Verbeast2K/zanzi-doc/README.md

# Index

## Gateway

- [BOM](./gateway/BOM.md)
- [Installation](./gateway/Installation.md)

## Backend

- [Infrastructure](./backend/infrastructure.md)
- [Installation via Ansible](./backend/ansible.md)
- [Influxdb](./backend/influxdb.md)

## Frontend

- [Grafana](./frontend/grafana.md)
