Verbeast2K/zanzi-doc/sensorbox/powersupply/README.md

# This map contains the files about the power supply and power usage of the sensor box
