Verbeast2K/zanzi-doc/sensorbox/enclosure/README.md

# Prototype enclosure Zanzibar sensor box
