Verbeast2K/zanzi-doc/gateway/housing_adapter.dxf

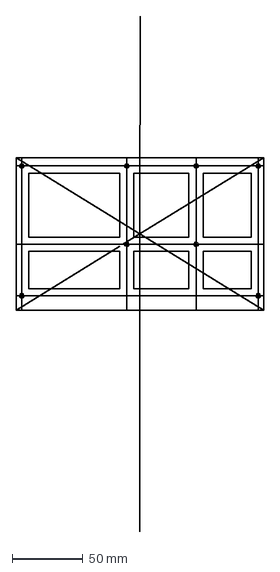
[picture p6: CAD file, 2023-06-07]
gateway/housing_adapter.dxf
175.0 x 365.0 mm
