Verbeast2K/zanzi-doc/sensorbox/enclosure/Panel_Top.stl

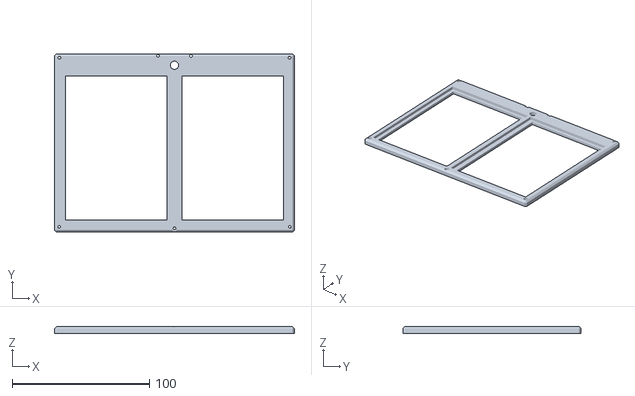
[picture p7: CAD file, 2023-06-08]
sensorbox/enclosure/Panel_Top.stl
175.0 x 130.0 x 5.00
