Verbeast2K/zanzi-doc/sensorbox/enclosure/SensorBox.stl

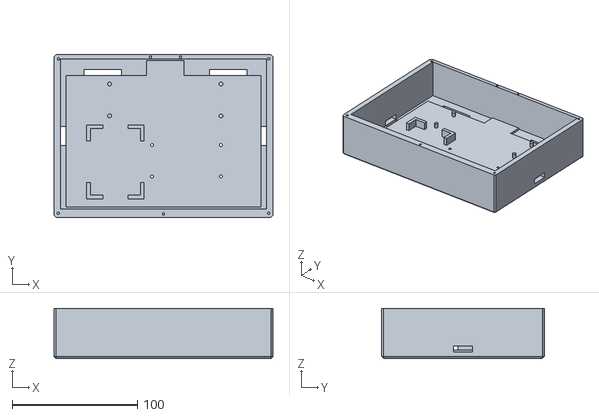
[picture p8: CAD file, 2023-06-08]
sensorbox/enclosure/SensorBox.stl
175.0 x 130.0 x 40.0
