Verbeast2K/zanzi-doc/(list of files, cad)

Other CAD files:
sensorbox/enclosure/SensorBox-Zanzibar_Waterproofing v12.f3d
