Verbeast2K/zanzi-doc/flwsb-testboard-main/README.md

# FLWSB I/O testboard
This is a testboard designed to test all the I/O pins of the FLWSB main board. 
Input functionality of the pin can be tested with a push button with pull-down configuration. Output can be tested with an led.

# Schematic 
FLWSB-testboard Figuur 1: PCB design of the testboard

# PCB design
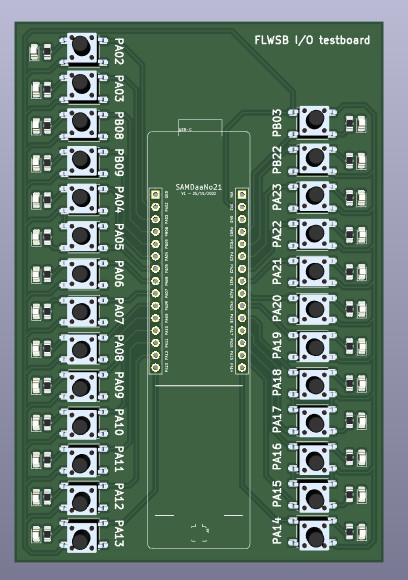
[picture p10: flwsb-testboard-main/assets/testboard.jpg]
FLWSB-testboard Figuur 1: PCB design of the testboard
