Verbeast2K/zanzi-doc/(commit log)

2023-06-06 add gateway documentation
    [housing_adapter.dxf]
2023-06-06 add wireguard doc
2023-06-06 main board
